analogairwaves/hydroSmart_hardware/hydSmart_VA/Release/VC/02_Assembly/hydroSmart_VC_bot_U2.png

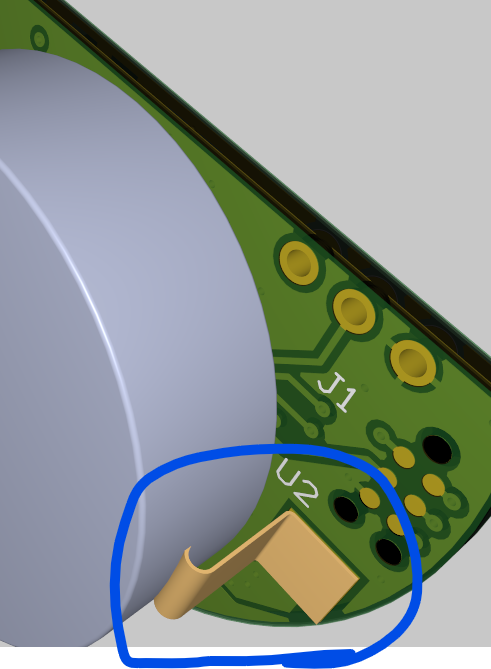
hydSmart_VA/Release/VC/02_Assembly/hydroSmart_VC_bot_U2.png
