analogairwaves/hydroSmart_hardware/hydSmart_VA/BOM_TEMP.xlsx

Column=Quantity | Column=Designator | Column=Comment | Column=Footprint | Column=Description | Column=Manufacturer_Name | Column=Manufacturer_Part_Number
Total
0
Approved
