analogairwaves/hydroSmart_hardware/hydSmart_VA/Release/VC/03_BOM/Bill of Materials-Hydrosmart Revised Schematics_2025-05-28T19_57_34_UTC.xlsx

Quantity | Designator | Comment | Footprint | Description | Manufacturer_Name | Manufacturer_Part_Number
1 | BT1 | Battery | BAT-2 | BATTERY LITHIUM 3V COIN 24.5MM | Jauch Quartz | CR2477
1 | C1 | 47uF | FP-C2012-125-0_2-MFG | Multilayer Ceramic Capacitors 47μF ±20% 6.3V X5R SMD 0805 | Taiyo Yuden | JMK212BBJ476MG-T
1 | C2 | 22uF | FP-GRM158-0_2-MFG | Chip Multilayer Ceramic Capacitors for General Purpose, 0402, 22uF, X5R, 15%, 20%, 10V | Murata Electronics | GRM158R60J226ME01D
2 | C3, C4 | 4.7uF | C0402 | CAP CER 4.7UF 16V X6T 0402 | Murata Electronics | GRM155D81C475ME15J
1 | IC1 | 24FC04HT-I/OT | SOT23-5 | IC EEPROM 4KBIT I2C 1MHZ SOT23-5 | Microchip | 24FC04HT-I/OT
1 | J1 | TC2030-IDC-NL | TC2030-IDC-NL | Header, 3-Pin, Dual row
1 | L2 | 4.7uH | FP-MLZ1608-IPC_A | Shielded Multilayer Inductor 4.7uH ±20% 350mA 650mΩ SMD 0603 | TDK Corporation | MLZ1608E4R7MT000
1 | M1 | AN54L15Q-U | AN54L15Q-U | AN54L15Q-U | Raytac | AN54L15Q-U
1 | R1 | 20K | R0402 | RES SMD 20K OHM 1% 1/10W 0402 | Panasonic Electronic Components | ERJ-2RKF2002X
2 | R2, R3 | 4.7K | R0402 | RES SMD 4.7K OHM 1% 1/10W 0402 | Panasonic Electronic Components | ERJ-2RKF4701X
1 | U1 | MAXM38643AEMB+ | MAXM38643AEMB | Integrated Circuit | Analog Devices | MAXM38643AEMB+
1 | U2 | 122 | 122 | BATT CONTACT SOLID MULTIPLE SMD | Keystone Electronics | 122
2 | U3, U4 | CT8122AM-IS3 | SOT95P280X135-3L | Integrated Bipolar TMR Digital Latch | Allegro MicroSystems | CT8122AM-IS3
1 | U5 | 112TR | 112TR | BATT CONTACT SPRING MULTIPLE SMD | Keystone Electronics | 112TR
1 | Y1 | FC-135_32.7680KA-AG5 | FC135327680KAAG5 | Crystal or Oscillator | Epson Timing | FC-135 32.7680KA-AG5
18
Approved
