analogairwaves/hydroSmart_hardware/hydSmart_VA/Release/VC/04_3D-Model/Hydrosmart_PCB.step

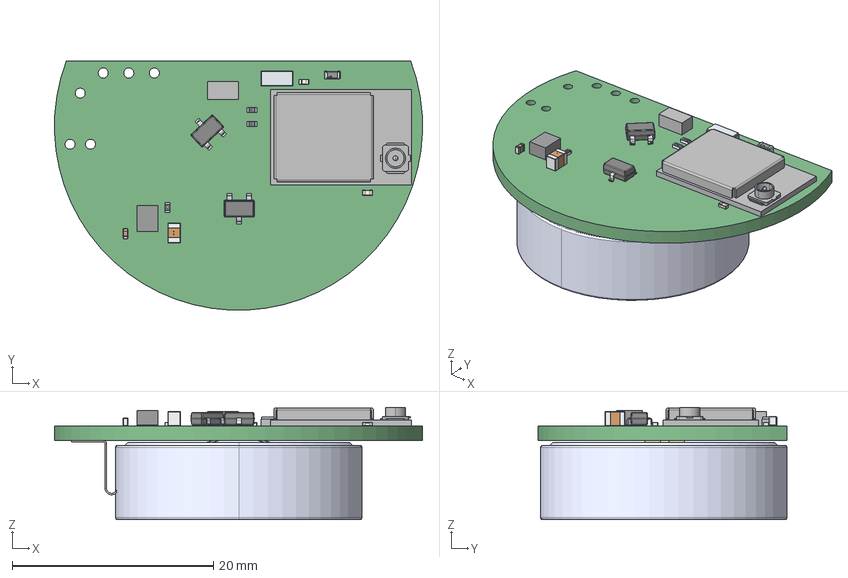
[picture p3: CAD file, 2025-07-02]
hydSmart_VA/Release/VC/04_3D-Model/Hydrosmart_PCB.step
36.6 x 24.8 x 11.2 mm
User Library-R SMD 0402_0402 BODY x 3
User Library-R SMD 0402_0402 PAD x 6
User Library-R SMD 0402_0402 OPIS x 3
User Library-0402C x 2
TDK Logo x 2
AN54L15Q-U-20250207_RGB8421504
solidBody
solidTop
solidLead
Leader x 6
Extruded
side x 2
Pins
Terminals
Center
Murata
keystone-PN122
CR2477--3DModel-STEP-56544
