analogairwaves/hydroSmart_hardware/Kicad/3D-Model/HydSmart_VA.step

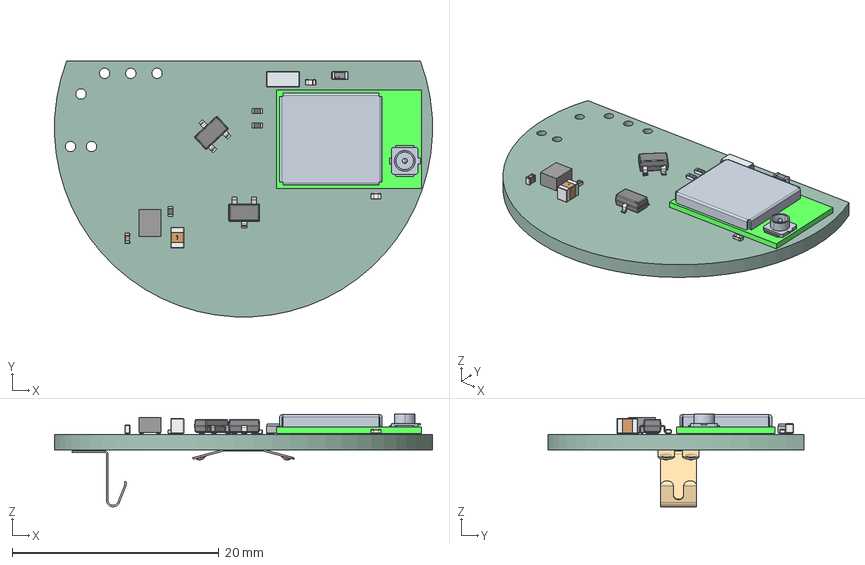
[picture p4: CAD file, 2025-09-03]
Kicad/3D-Model/HydSmart_VA.step
36.6 x 24.7 x 8.96 mm
kicad_embedded_304F4459D830F1485C242EDFF635C66E
solidBody
solidTop
solidLead
Terminals
Center
Murata
side x 2
TDK Logo x 2
User Library-R SMD 0402_0402 BODY x 3
User Library-R SMD 0402_0402 PAD x 6
User Library-R SMD 0402_0402 OPIS x 3
kicad_embedded_D37FDB8596E1CEA1394E1E511EF79DD1 x 2
Leader x 6
Pins
kicad_embedded_DB89A9A00988E94D0ABF6F59B23D8A71
kicad_embedded_F52669B941F0F4BC2BC707CB907FF618
HydSmart_VA_PCB
