analogairwaves/hydroSmart_hardware/hydSmart_VA/Release/VC/Hydrosmart Revised Schematics_2025-05-28T19_57_34_UTC.pdf

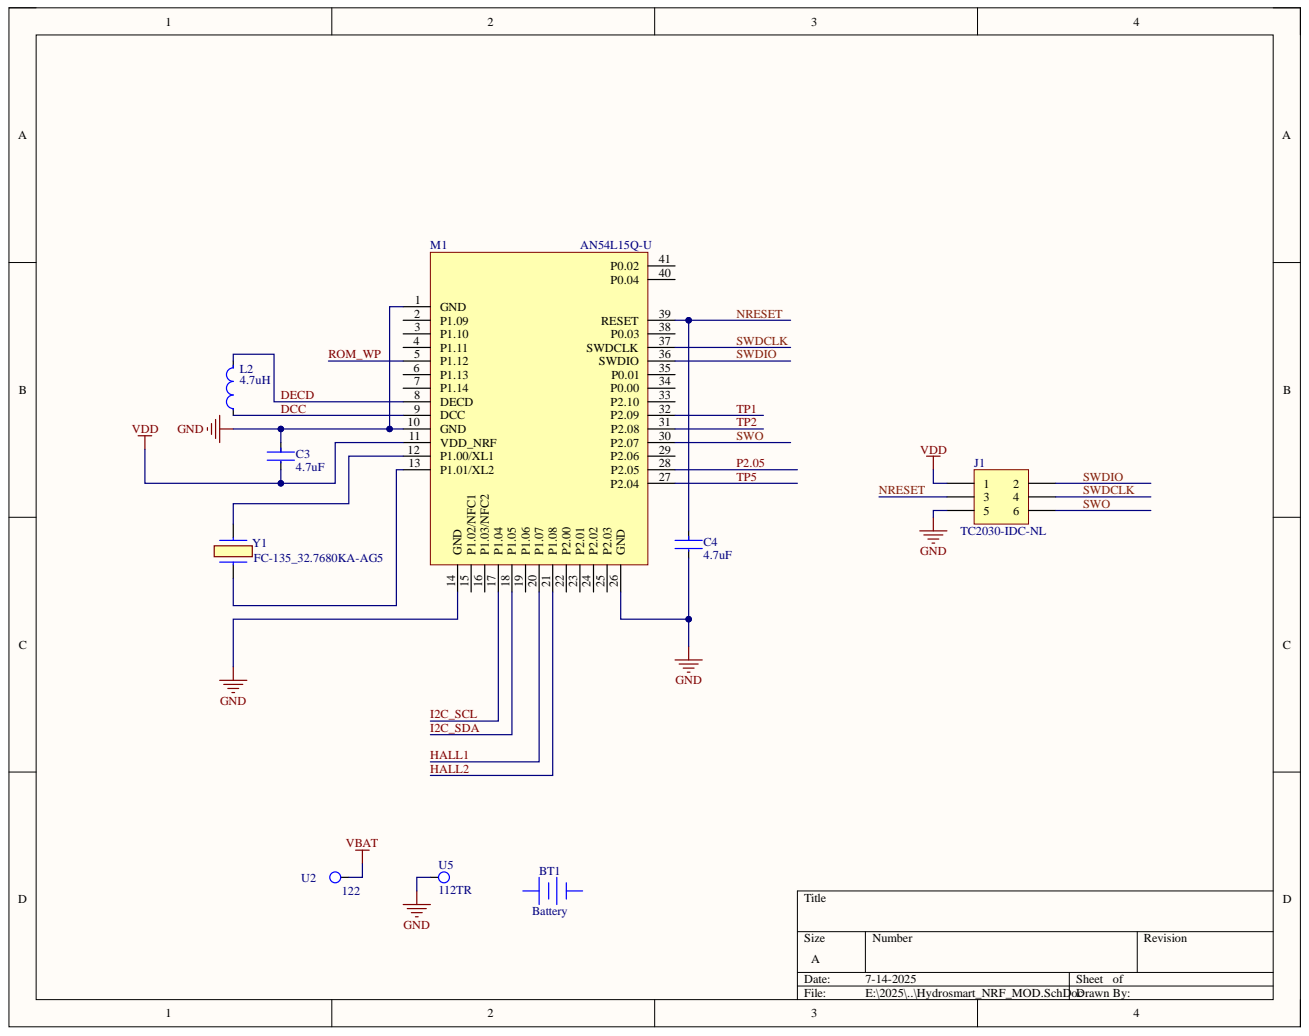
[picture p5: page 1]

L2 4.7uH DECD

DCC 9

VDD_NRF 11

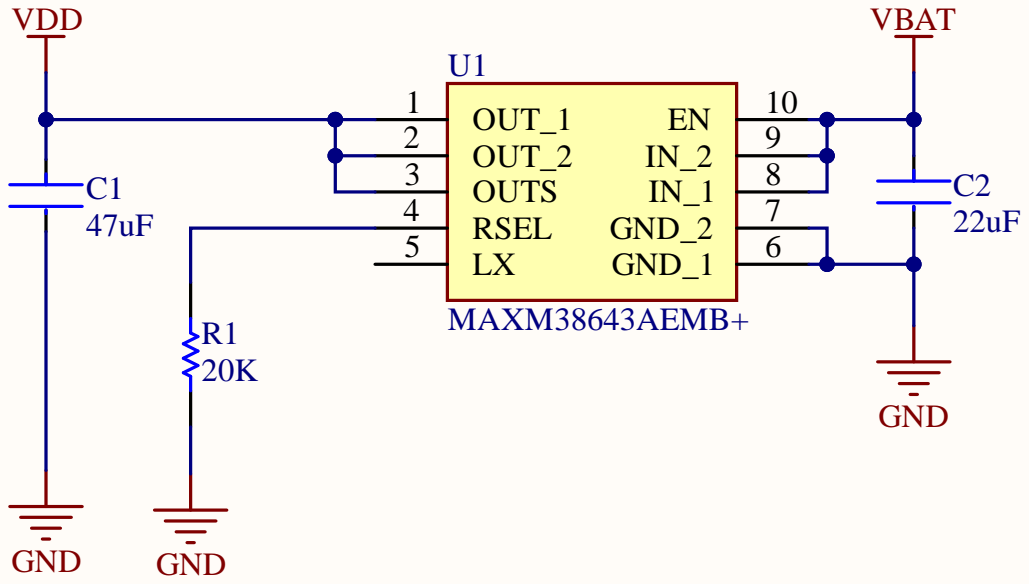
[picture p6: page 2]

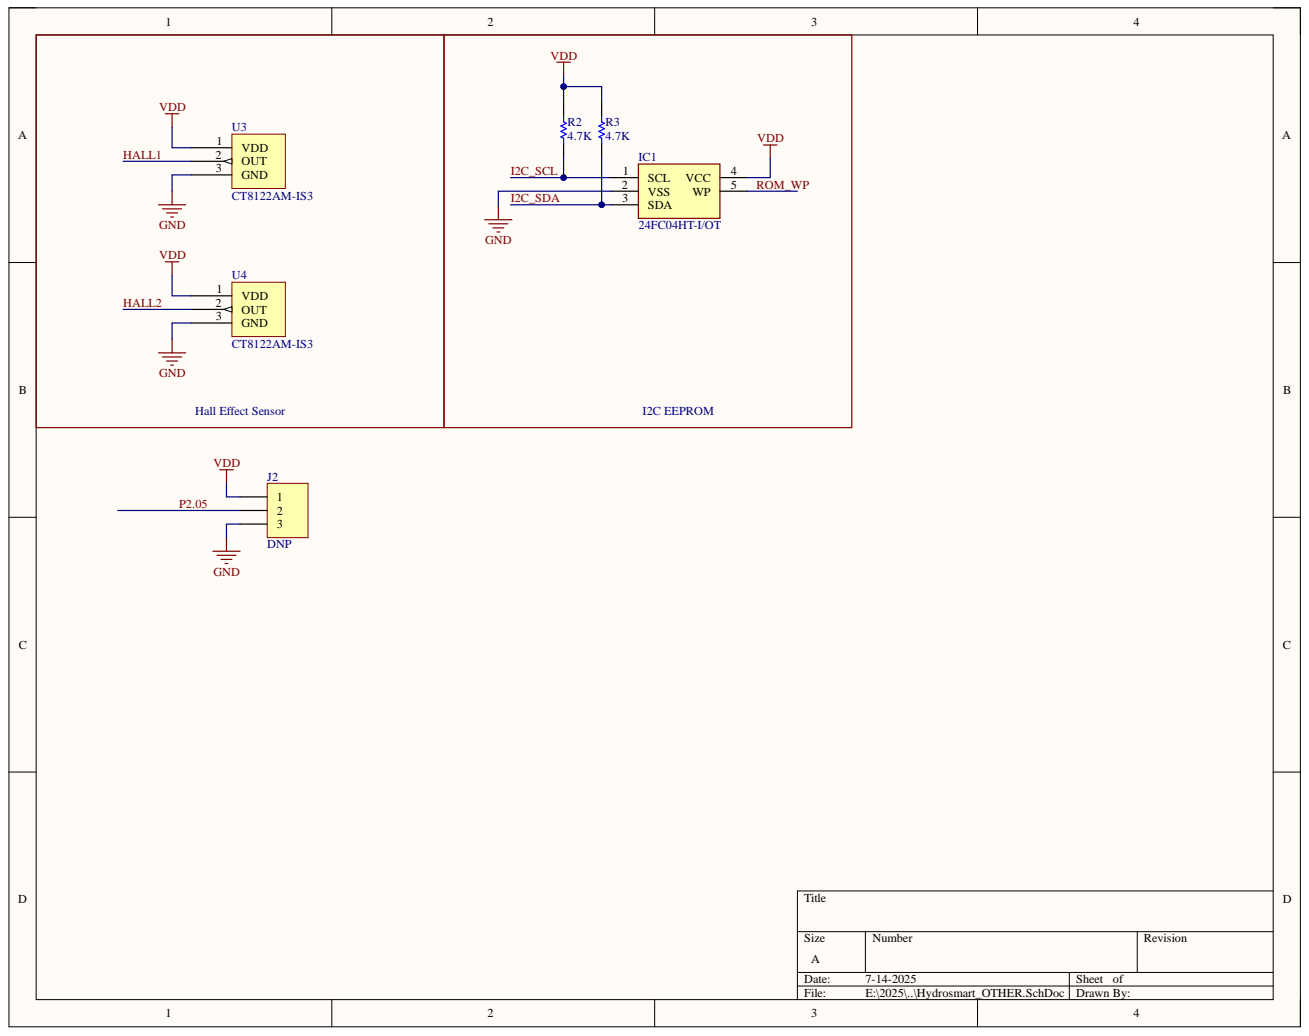
[picture p7: page 3]
