analogairwaves/hydroSmart_hardware/(list of files, drawings)

Other design files:
hydSmart_VA/112TR.PcbLib
hydSmart_VA/122.PcbLib
hydSmart_VA/C0201.PcbLib
hydSmart_VA/Hydrosmart Revised Schematics_2025-05-28T19_57_34_UTC.PrjPcb
hydSmart_VA/Hydrosmart Revised Schematics_2025-05-28T19_57_34_UTC.SCHLIB
hydSmart_VA/Hydrosmart_Flexi.PcbDoc
hydSmart_VA/Hydrosmart_NRF.SchDoc
hydSmart_VA/Hydrosmart_NRF_MOD.SchDoc
hydSmart_VA/Hydrosmart_OTHER.SchDoc
hydSmart_VA/Hydrosmart_PCB1.PcbLib
hydSmart_VA/Hydrosmart_PCB2.PcbLib
hydSmart_VA/Hydrosmart_PCB.PcbDoc
hydSmart_VA/Hydrosmart_PWR.SchDoc
hydSmart_VA/TC2030-IDC-NL.PcbLib
