analogairwaves/hydroSmart_hardware/hydSmart_VA/Release/VC/02_Assembly/HydroSmart_VC_assemblyBot.png

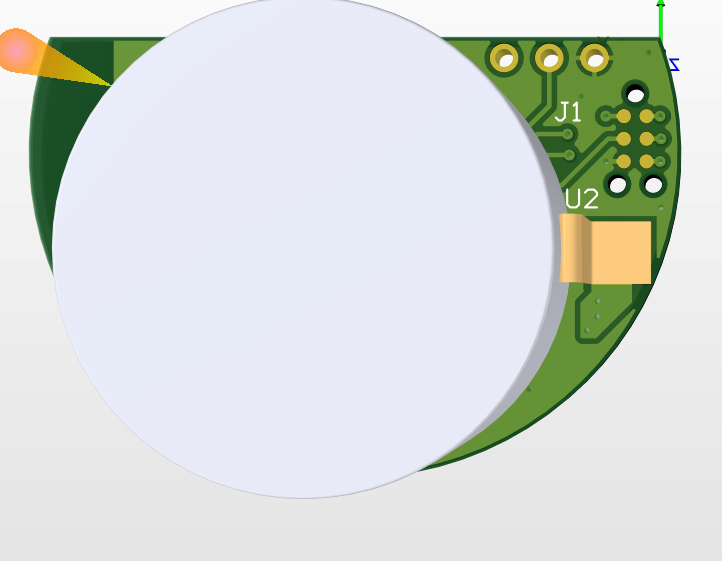
hydSmart_VA/Release/VC/02_Assembly/HydroSmart_VC_assemblyBot.png
