analogairwaves/hydroSmart_hardware/hydSmart_VA/Release/VC/02_Assembly/hydroSmart_VC_top.png

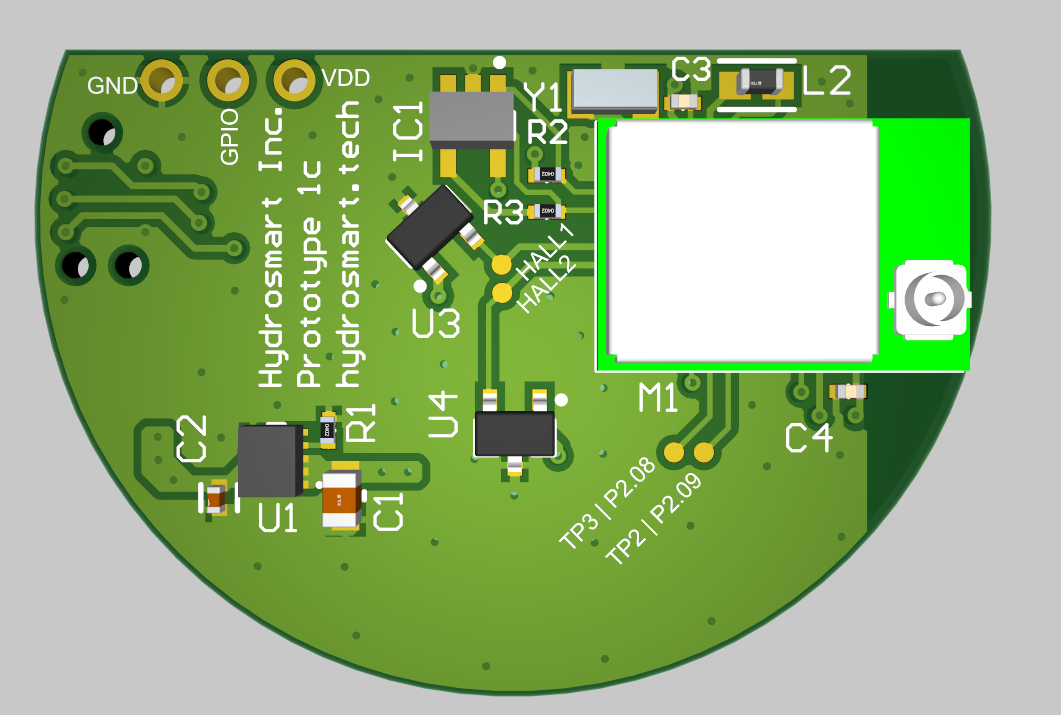
hydSmart_VA/Release/VC/02_Assembly/hydroSmart_VC_top.png
