analogairwaves/hydroSmart_hardware/(commit log)

2025-06-27 VA released initial commit
    [Hydrosmart Revised Schematics_2025-05-28T19_57_34_UTC.PrjPcb, Hydrosmart_Flexi.PcbDoc, Hydrosmart_NRF.SchDoc, Hydrosmart_NRF_MOD.SchDoc, Hydrosmart_OTHER.SchDoc, Hydrosmart_PCB.PcbDoc, Hydrosmart_PWR.SchDoc]
2025-06-27 Checked, updated design
    + Checked, updated information related to BOM.
    + Updated PCB.
    + Generated manufacturing files.
    [BOM_TEMP.xlsx, Hydrosmart Revised Schematics_2025-05-28T19_57_34_UTC.PrjPcb, Hydrosmart Revised Schematics_2025-05-28T19_57_34_UTC_2025-06-27.xlsx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]
2025-06-30 + Updated design based on new notes
    [112TR.PcbLib, 122.PcbLib, C0201.PcbLib, Hydrosmart Revised Schematics_2025-05-28T19_57_34_UTC.PrjPcb, Hydrosmart_Flexi.PcbDoc, Hydrosmart_NRF_MOD.SchDoc, Hydrosmart_OTHER.SchDoc, Hydrosmart_PCB.PcbDoc]
2025-06-30 + Added 3D model
    [Hydrosmart_PCB.step]
2025-07-01 - Updated information related to BOM
    [Hydrosmart Revised Schematics_2025-05-28T19_57_34_UTC.PrjPcb, Hydrosmart_NRF_MOD.SchDoc, Hydrosmart_OTHER.SchDoc]
2025-07-02 + Updated design based on new notes, generated manufacturing files and 3D model
    [Hydrosmart Revised Schematics_2025-05-28T19_57_34_UTC.PrjPcb, Hydrosmart Revised Schematics_2025-05-28T19_57_34_UTC.xlsx, Hydrosmart Revised Schematics_2025-05-28T19_57_34_UTC_2025-06-27.xlsx, Hydrosmart_NRF_MOD.SchDoc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]
2025-07-02 + Fixed 3D model, moved U2 label
    [Hydrosmart_PCB.GBL, Hydrosmart_PCB.GBO, Hydrosmart_PCB.GBP, Hydrosmart_PCB.GBS, Hydrosmart_PCB.GTL, Hydrosmart_PCB.GTO, Hydrosmart_PCB.GTP, Hydrosmart_PCB.GTS]
2025-07-02 + Updated schematic
    [Hydrosmart Revised Schematics_2025-05-28T19_57_34_UTC.PrjPcb, Hydrosmart Revised Schematics_2025-05-28T19_57_34_UTC.xlsx, Hydrosmart_NRF_MOD.SchDoc, Hydrosmart_OTHER.SchDoc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]
2025-07-02 + Added pull up resistors for I2C signals
    [Bill of Materials-Hydrosmart Revised Schematics_2025-05-28T19_57_34_UTC.xlsx, Hydrosmart Revised Schematics_2025-05-28T19_57_34_UTC.xlsx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]
2025-07-02 + Moved programming pads to back side
    [Hydrosmart Revised Schematics_2025-05-28T19_57_34_UTC.PrjPcb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]
2025-07-09 assembly diagrams added
2025-07-13 + Fixed issue on U2 and U5, added battery to the schematic and BOM
    [Bill of Materials-Hydrosmart Revised Schematics_2025-05-28T19_57_34_UTC.xlsx, Hydrosmart Revised Schematics_2025-05-28T19_57_34_UTC.PrjPcb, Hydrosmart Revised Schematics_2025-05-28T19_57_34_UTC.SCHLIB, Hydrosmart_NRF_MOD.SchDoc]
2025-07-23 assembly pictures added
    [hydroSmart_Bom_VC.xlsx]
2025-09-03 + Converted design to Kicad, exported 3D model
    [HydSmart_VA.kicad_pcb, HydSmart_VA.kicad_sch, HydSmart_VA.step, Hydrosmart_NRF_MOD.kicad_sch, Hydrosmart_OTHER.kicad_sch, Hydrosmart_PWR.kicad_sch]
2025-09-04 + Created library and added information related to BOM: MANUFACTURER and MANUFACTURER PN
    [HydSmart_VA.kicad_pcb, Hydrosmart_NRF_MOD.kicad_sch, Hydrosmart_OTHER.kicad_sch, Hydrosmart_PWR.kicad_sch]
2025-09-12 VB changes start. Updated regulator and added test points
    [HydSmart_VA.kicad_pcb, HydSmart_VA.kicad_sch, Hydrosmart_NRF_MOD.kicad_sch, Hydrosmart_OTHER.kicad_sch, Hydrosmart_PWR.kicad_sch]
